tgwgraham/autoinjector/README.md

Description of autoinjector system built on Tjian-Darzacq Group single-molecule tracking microscope. See "autoinjector_description.pdf" for details.
