tgwgraham/autoinjector/syringe_clamp_part1.stl

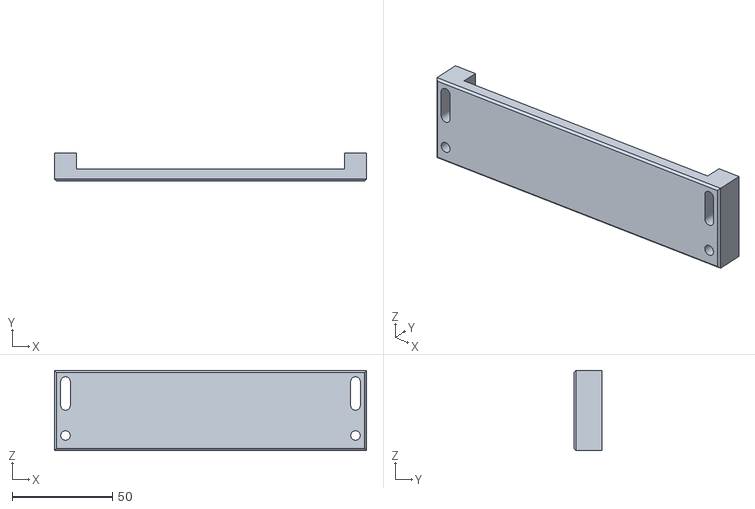
[picture p5: CAD file, 2024-05-27]
syringe_clamp_part1.stl
156.0 x 14.0 x 40.0
