tgwgraham/autoinjector/syringe_clamp_part2.stl

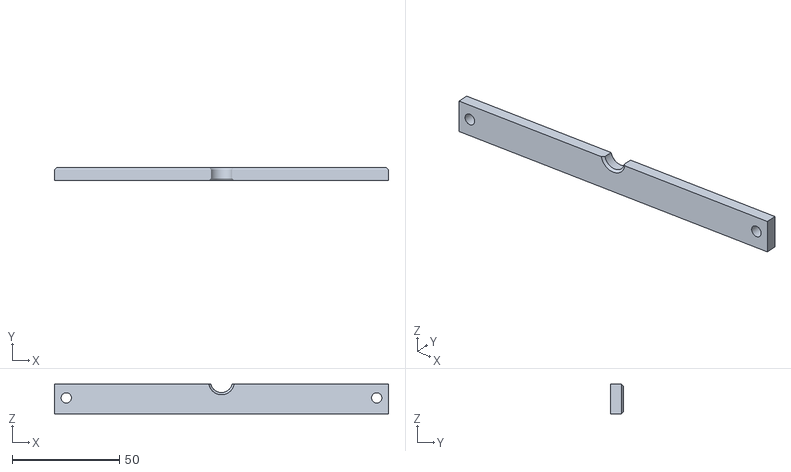
[picture p6: CAD file, 2024-05-27]
syringe_clamp_part2.stl
156.0 x 6.00 x 14.0
