tgwgraham/autoinjector/MatTek_perfusion_lid_insert.stl

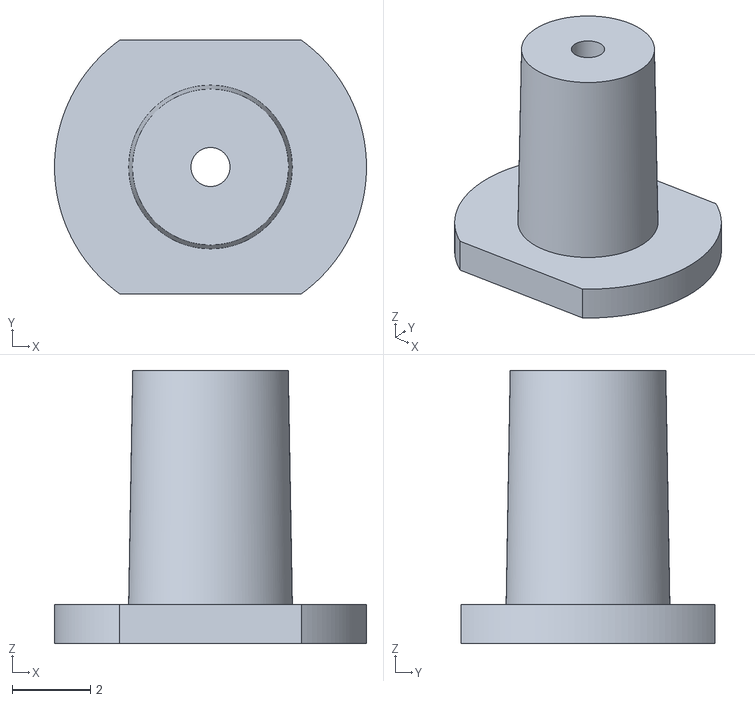
[picture p7: CAD file, 2024-05-27]
MatTek_perfusion_lid_insert.stl
8.00 x 6.50 x 7.00
