tgwgraham/autoinjector/MatTek_perfusion_lid.stl

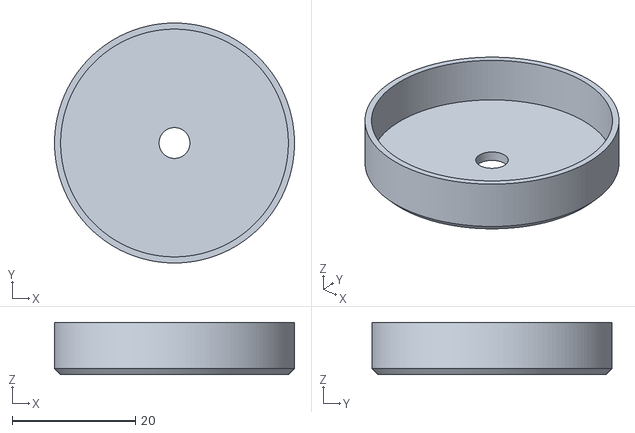
[picture p8: CAD file, 2024-05-27]
MatTek_perfusion_lid.stl
39.0 x 39.0 x 8.50
